MH-Electronic/RISC-V-Processor-Design/Documents/EEE499_FYPSLIDES-LIEW_MING_HENG.pdf

## Efficient VLSI Design-Based Adaptive Pipelined RISC-V Core

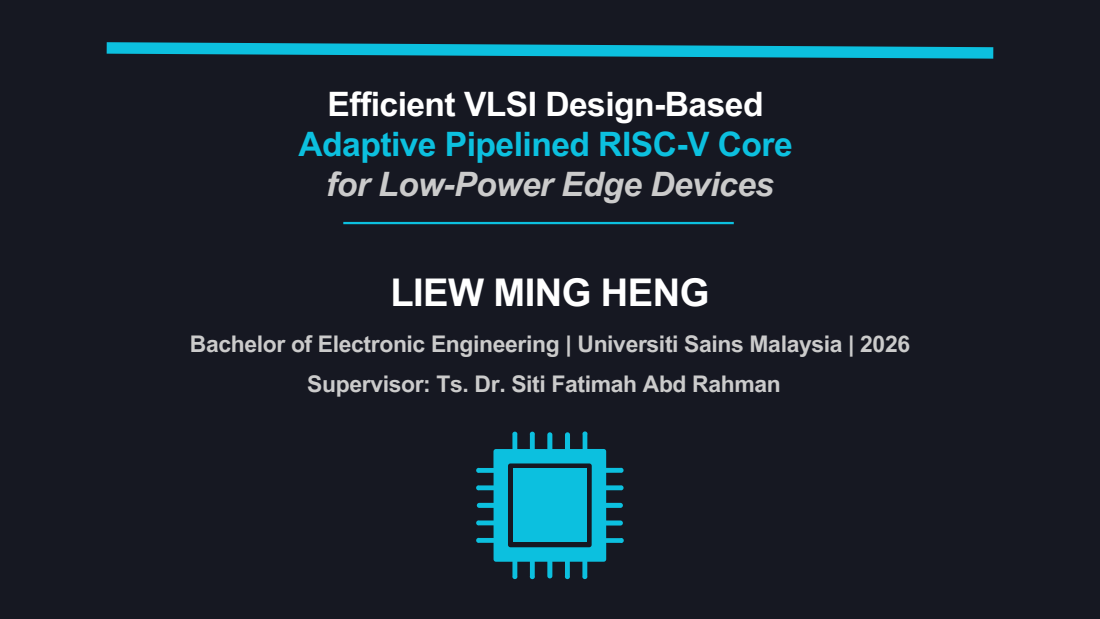
[picture p48: page 1]

for Low-Power Edge Devices

LIEW MING HENG

Bachelor of Electronic Engineering | Universiti Sains Malaysia | 2026

Supervisor: Ts. Dr. Siti Fatimah Abd Rahman

## RESEARCH BACKGROUND

## PROBLEM STATEMENT

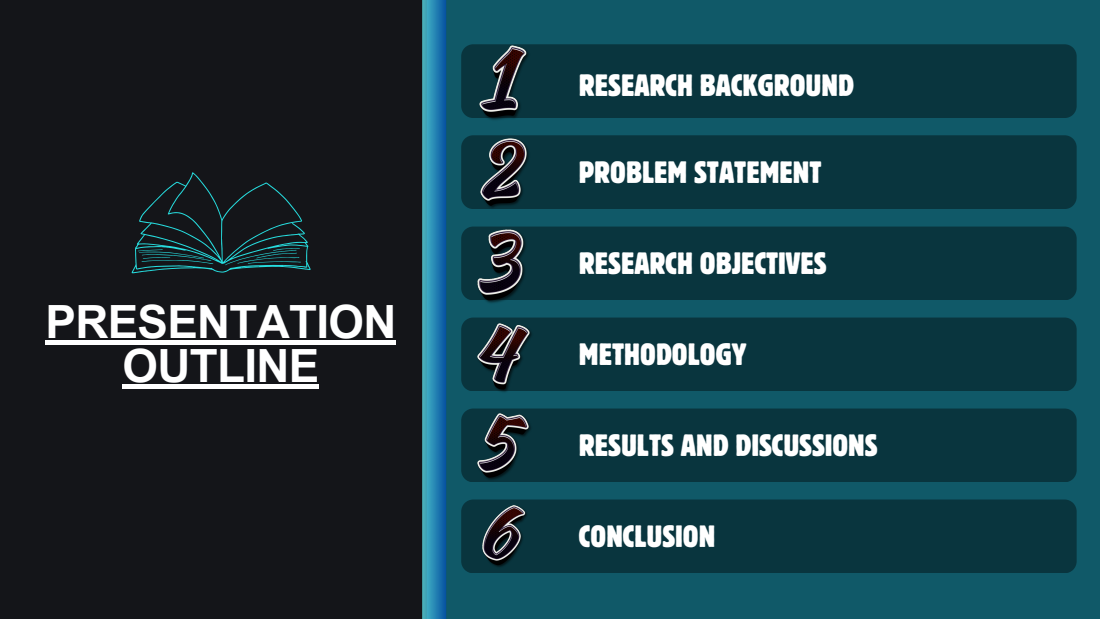
[picture p49: page 2]
PRESENTATION OUTLINE; RESEARCH OBJECTIVES; METHODOLOGY; CONCLUSION

RESULTS AND DISCUSSIONS

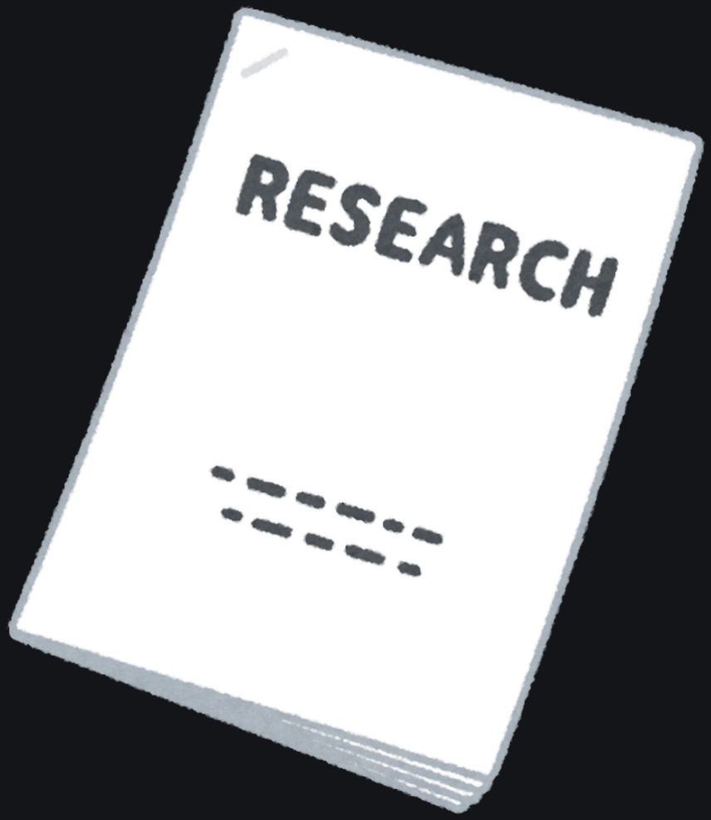
[picture p50: figure]

# RESEARCH BACKGROUND

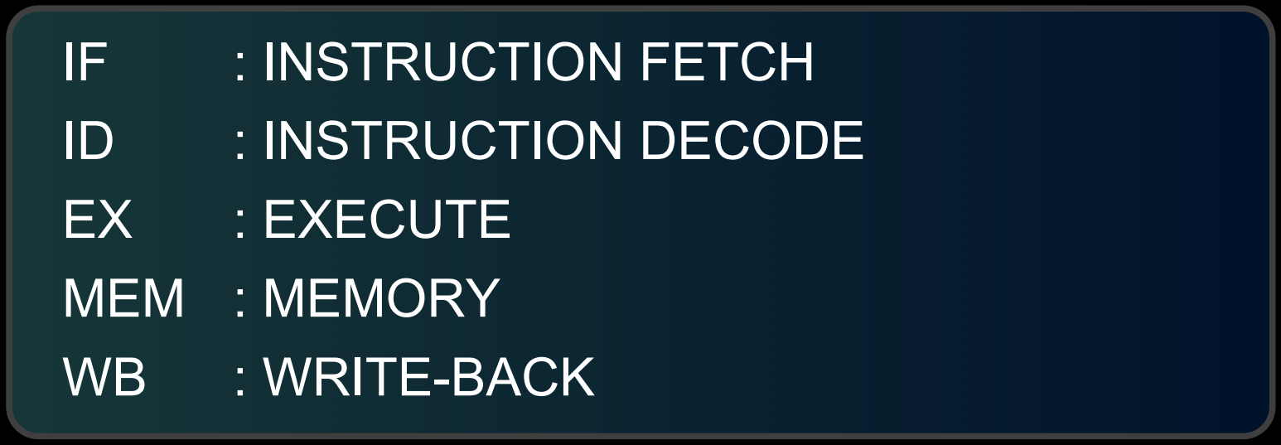
[picture p51: figure]
IF ID EX MEM WB; : INSTRUCTION FETCH : INSTRUCTION DECODE : EXECUTE : MEMORY : WRITE-BACK
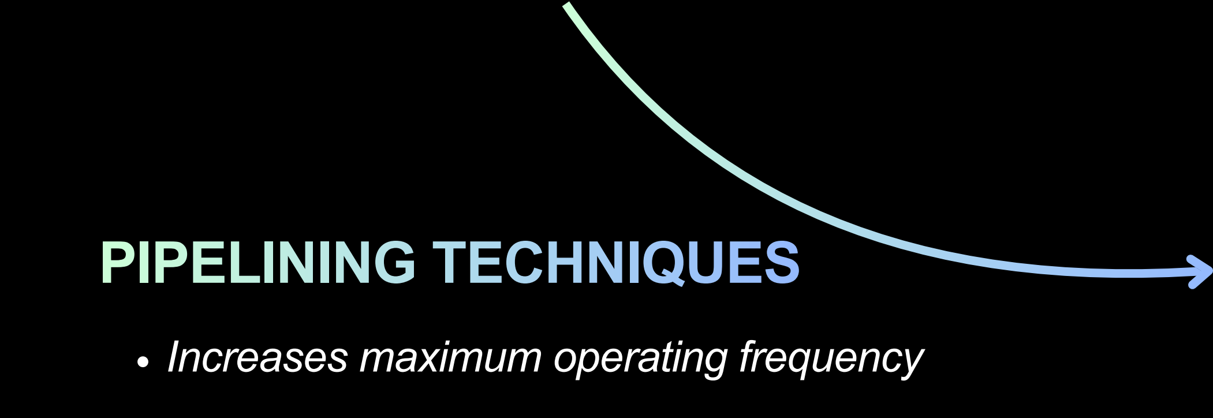
[picture p52: figure]
PIPELINING TECHNIQUES; Increases maximum operating frequency

## 5-STAGE PROCESSOR

# RESEARCH BACKGROUND

## SINGLE-CYCLE PROCESSOR

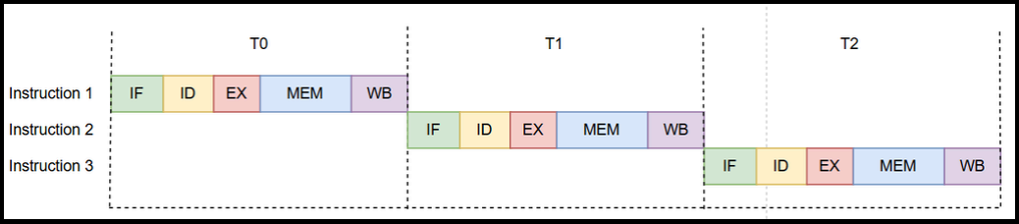
[picture p53: figure]
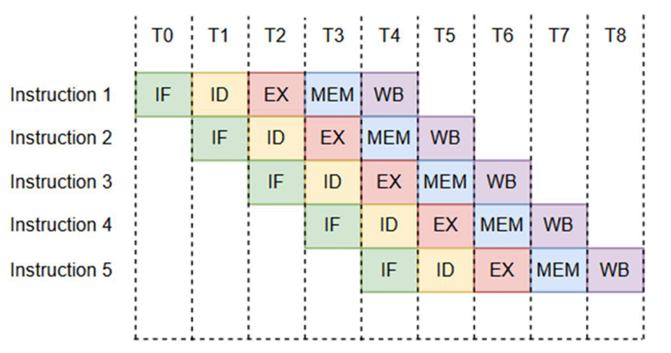
[picture p54: figure]

## DYNAMIC POWER EQUATION

α: Switching Activity Factor C: Effective Load Capacitance V: Supply Voltage
f: Operating Frequency

# RESEARCH BACKGROUND

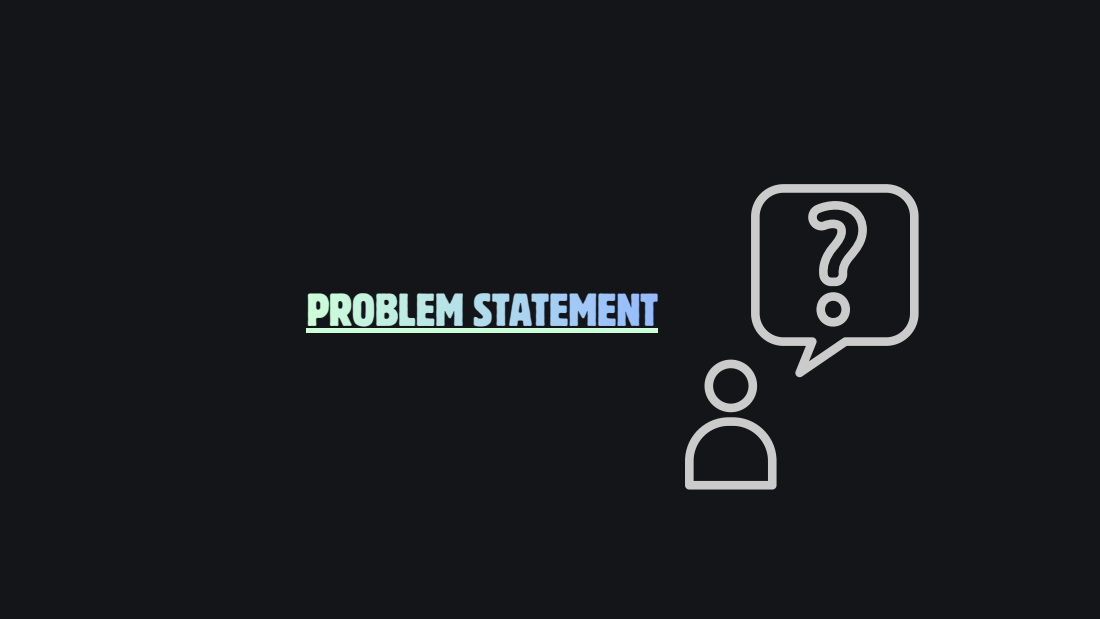
[picture p55: page 6]
PROBLEM STATEMENT

## PROBLEM STATEMENT

PROBLEM 1: RIGID PIPELINE TRADE-OFF & HAZARD PENALTY

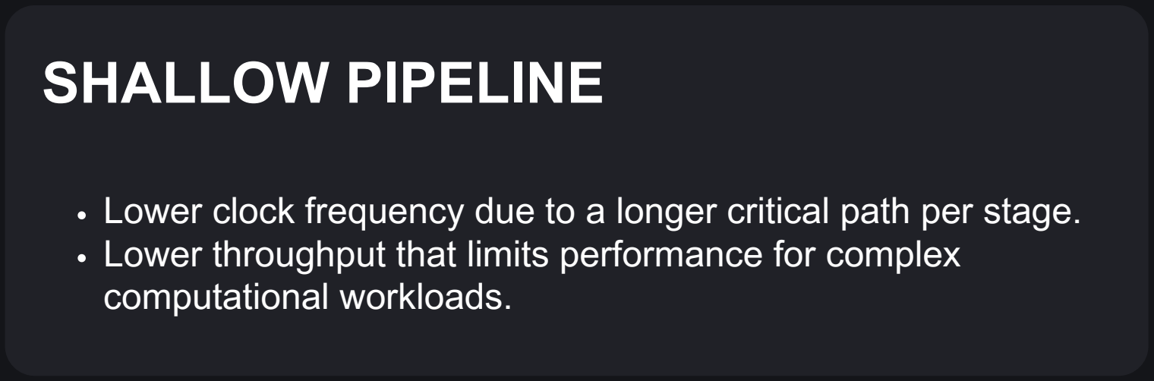
[picture p56: figure]
computational workloads.; SHALLOW PIPELINE
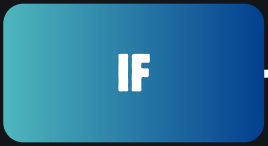
[picture p57: figure]
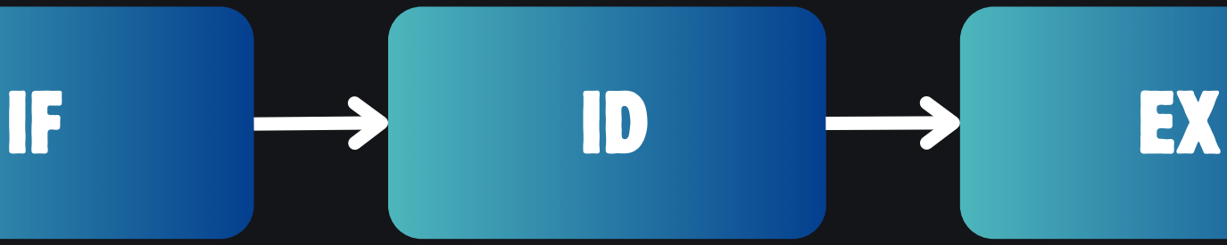
[picture p58: figure]
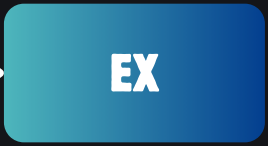
[picture p59: figure]

Lower clock frequency due to a longer critical path per stage. Lower throughput that limits performance for complex

IF | ID | EX | MEM | WB

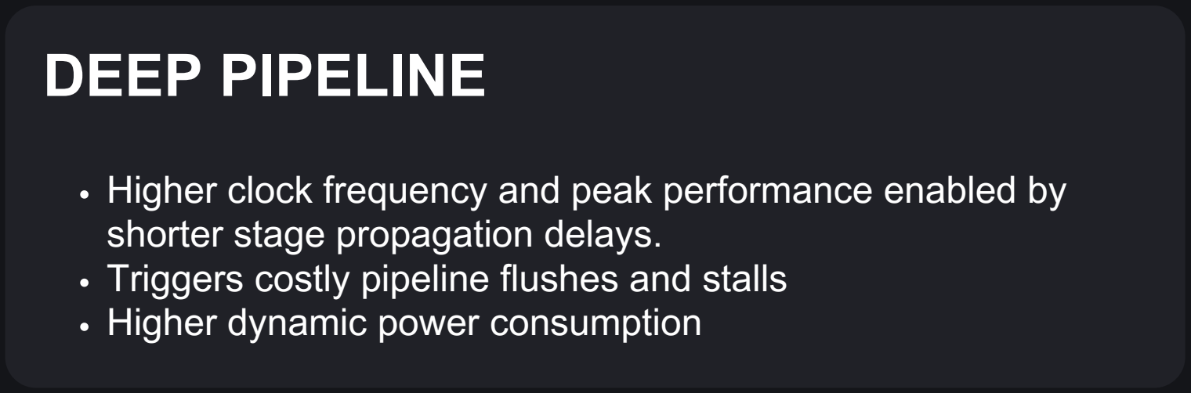
[picture p60: figure]
DEEP PIPELINE; shorter stage propagation delays.; Higher dynamic power consumption

Higher clock frequency and peak performance enabled by

Triggers costly pipeline flushes and stalls

## PROBLEM STATEMENT

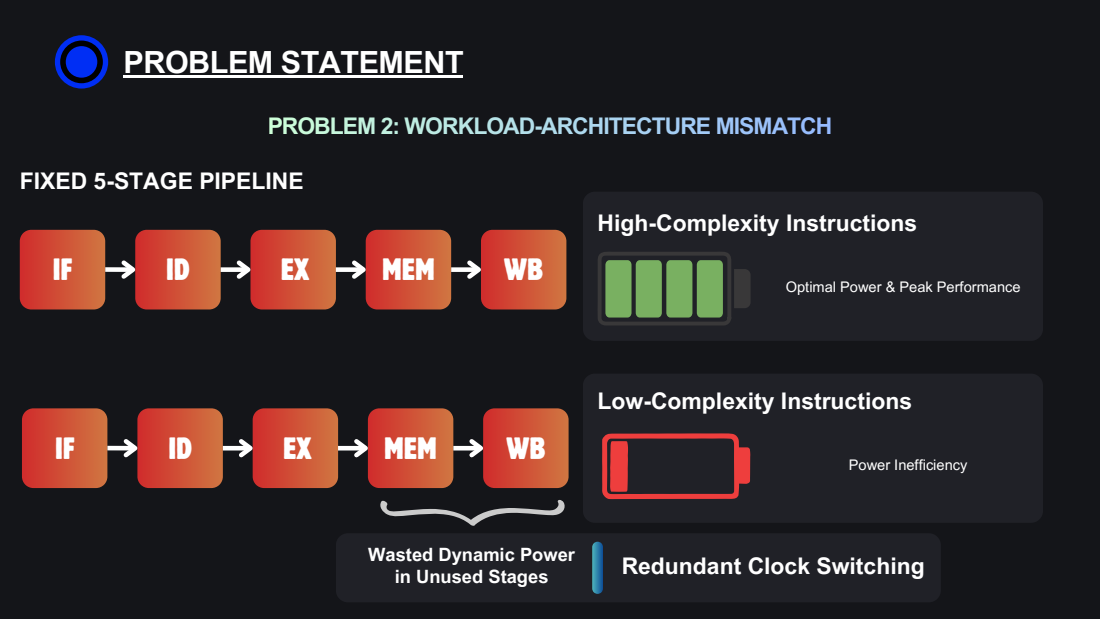
[picture p61: page 8]
MEM; Power Inefficiency; in Unused Stages; Redundant Clock Switching

PROBLEM 2: WORKLOAD-ARCHITECTURE MISMATCH

FIXED 5-STAGE PIPELINE

High-Complexity Instructions

Optimal Power & Peak Performance

Low-Complexity Instructions

Wasted Dynamic Power

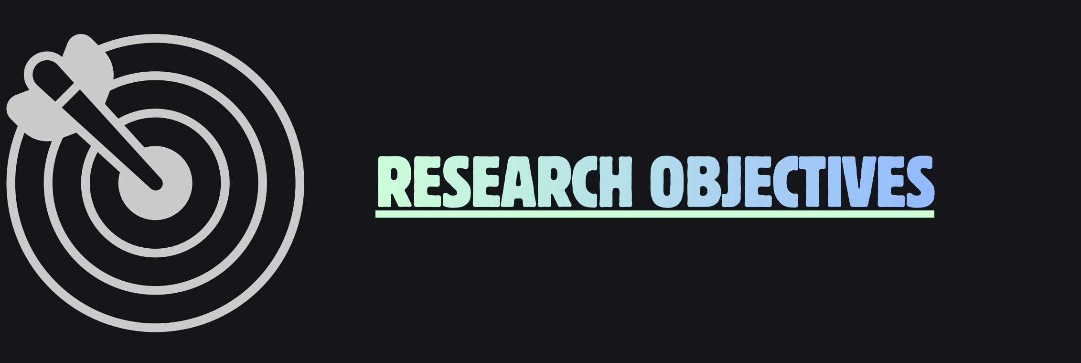
[picture p62: figure]
RESEARCH OBJECTIVES

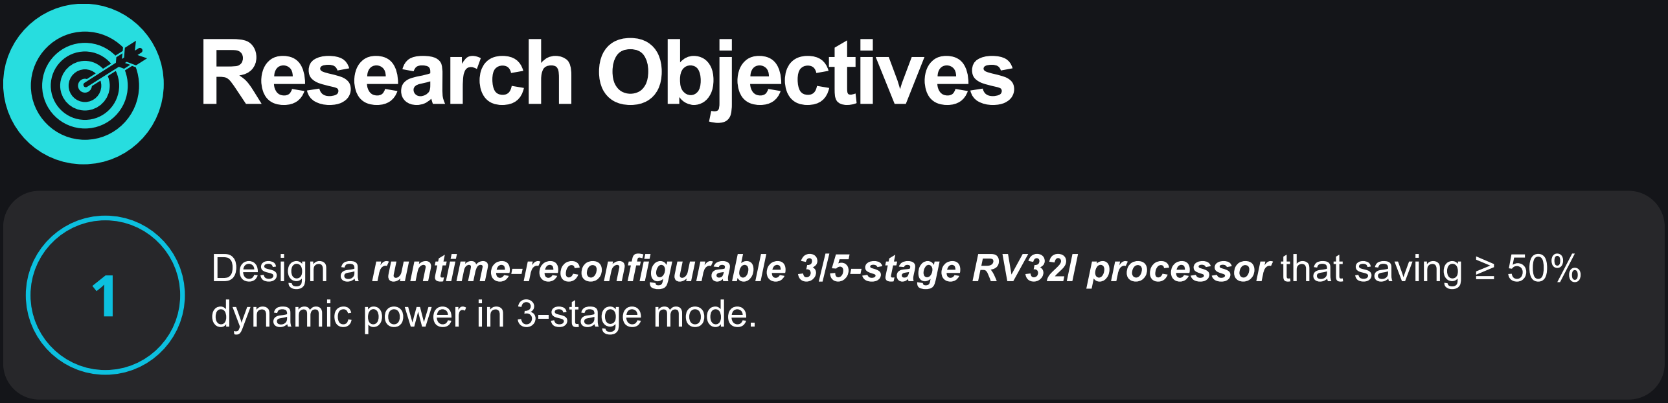
[picture p63: figure]
Research Objectives; dynamic power in 3-stage mode.

Design a runtime-reconfigurable 3/5-stage RV32I processor that saving ≥ 50%

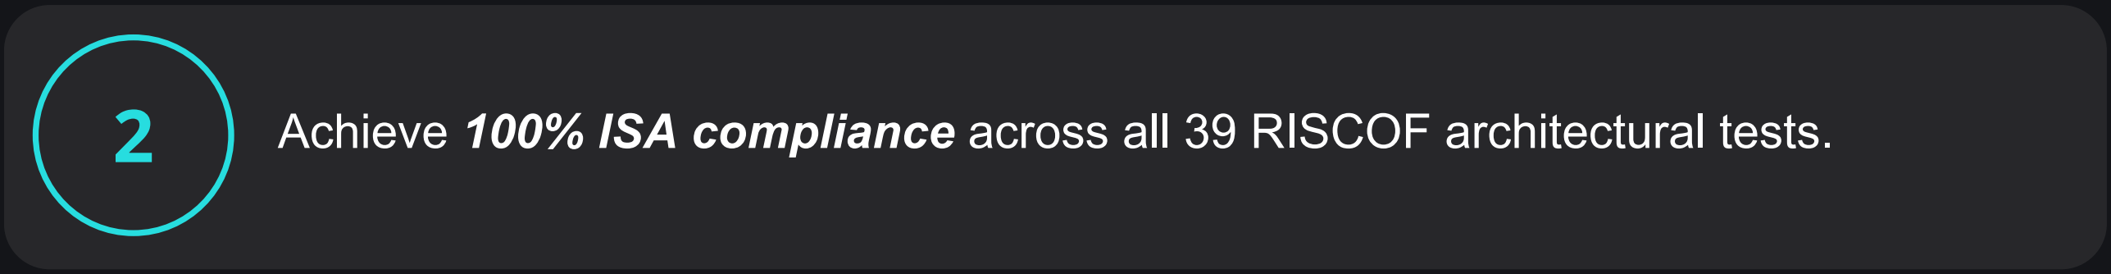
[picture p64: figure]

Achieve 100% ISA compliance across all 39 RISCOF architectural tests.

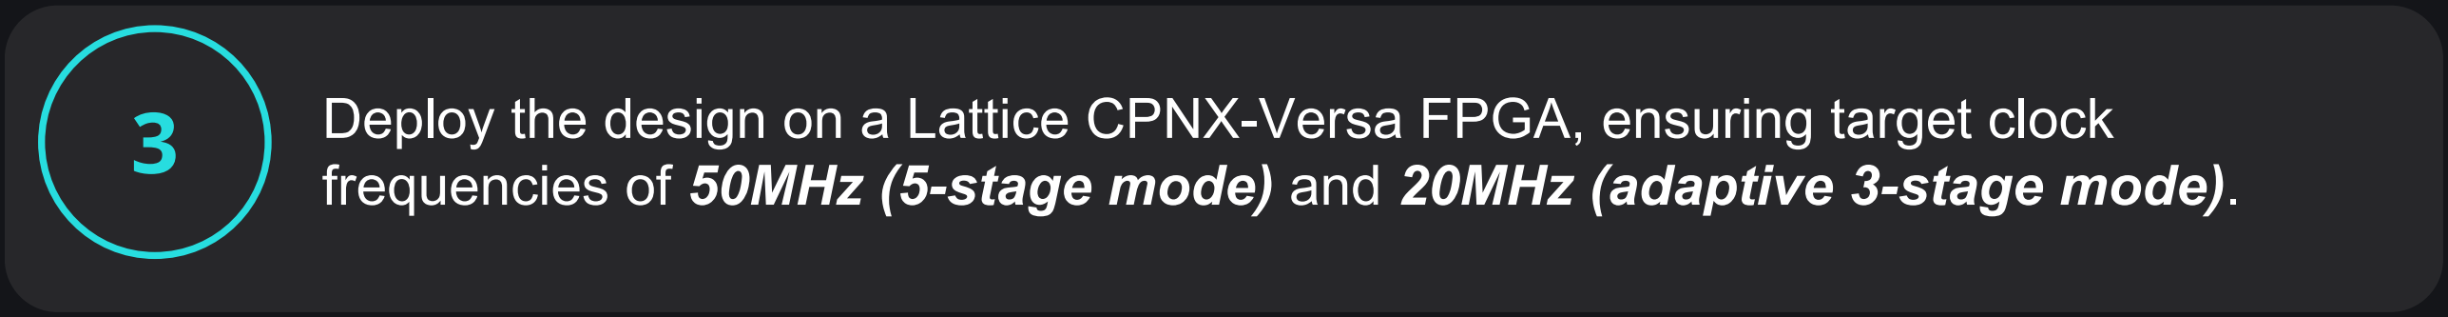
[picture p65: figure]

Deploy the design on a Lattice CPNX-Versa FPGA, ensuring target clock frequencies of 50MHz (5-stage mode) and 20MHz (adaptive 3-stage mode).

# Existed Research vs Proposed Work

Minimalist Soft-Cores | High-Performance | Proposed Work
PicoRV32 | Rocket SSR

Pipeline Depth

Hazard Strategy
Overhead

Verification

Application

Rigid Multi-Cycle | Rigid Fixed 5-Stage | Runtime- Reconfigurable
Zero | High Power Penalty | Dynamic Elimination via Stage Unification
Local Testbenches | RISCOF | RISCOF
FPGA Soft-Core | ASIC | Lattice CPNX FPGA

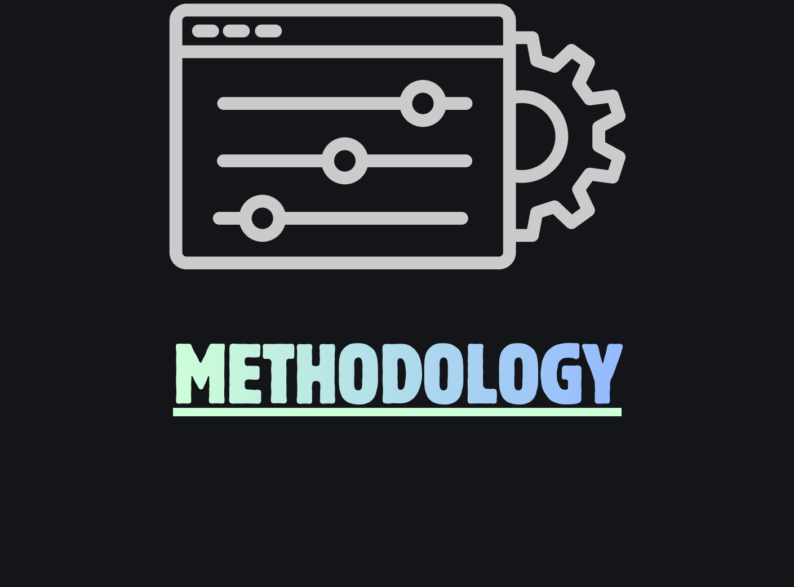
[picture p66: figure]
METHODOLOGY
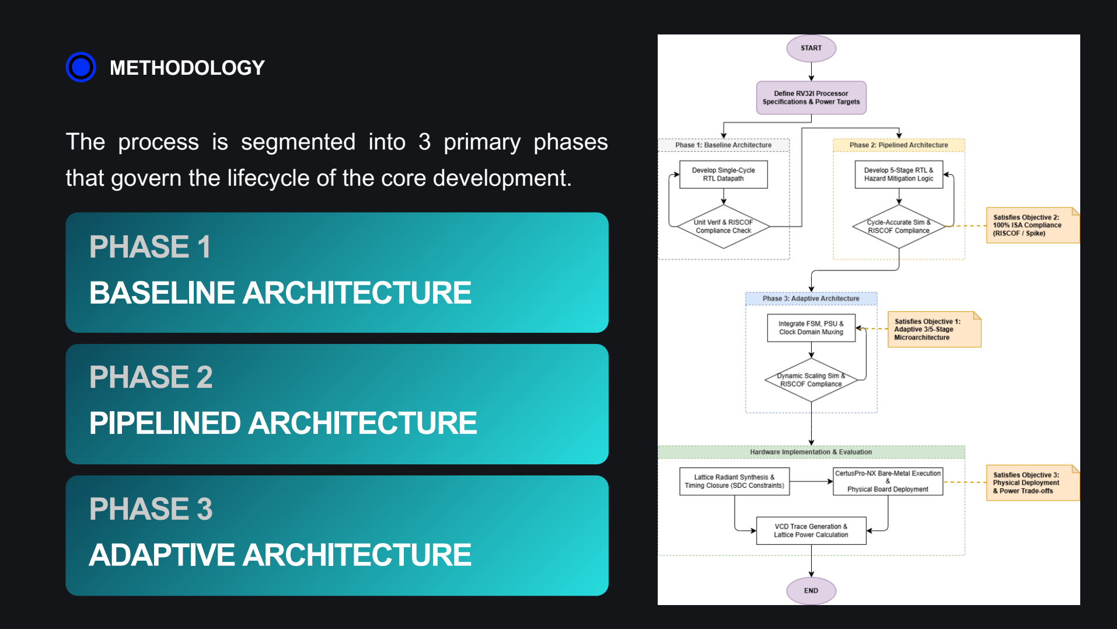
[picture p67: page 13]

The process is segmented into 3 primary phases that govern the lifecycle of the core development.

METHODOLOGY

## PHASE 3 ADAPTIVE ARCHITECTURE

## PHASE 2 PIPELINED ARCHITECTURE

## PHASE 1 BASELINE ARCHITECTURE

# Project Resources

SOFTWARE | HARDWARE

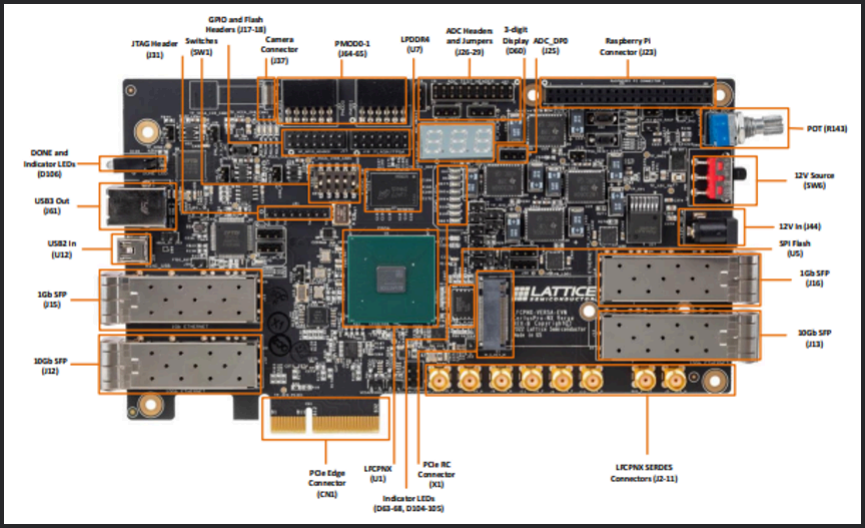
[picture p68: figure]

Lattice CPNX Versa FPGA Board

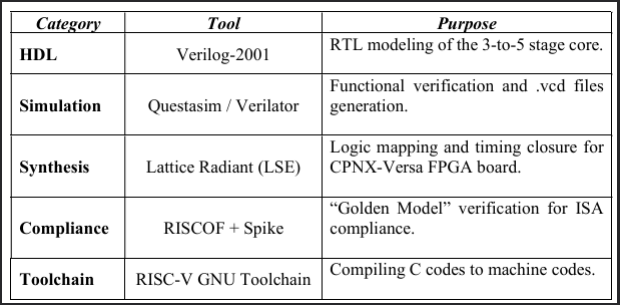
[picture p69: figure]

## PHASE 1

## Own Design

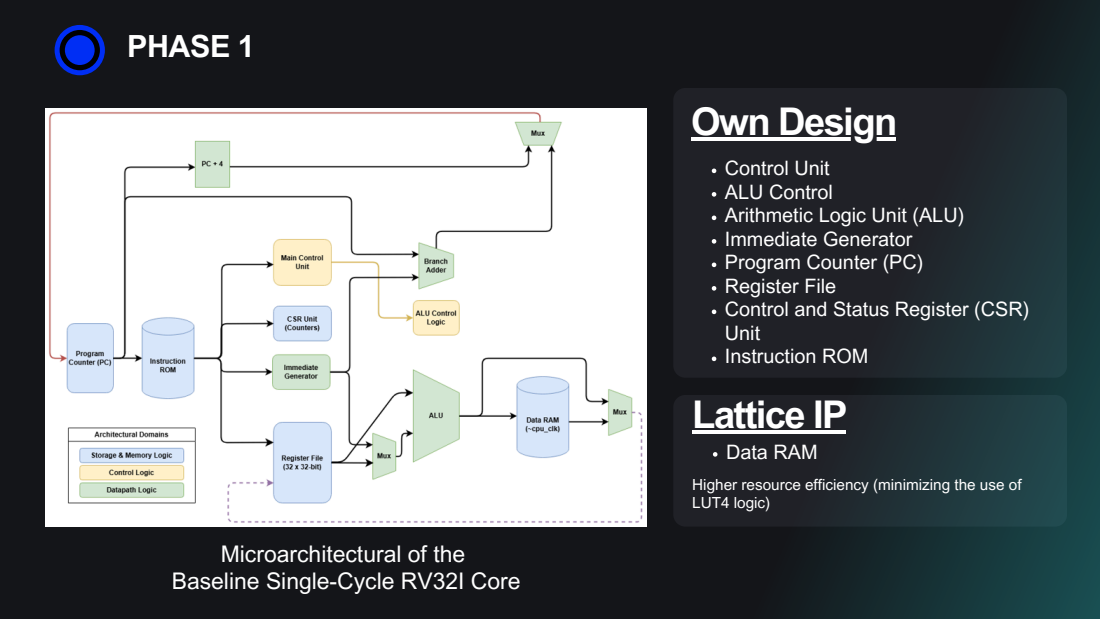
[picture p70: page 15]
Data RAM

Control Unit
ALU Control
Arithmetic Logic Unit (ALU)
Immediate Generator
Program Counter (PC)
Register File
Control and Status Register (CSR)
Unit
Instruction ROM
Lattice IP

Higher resource efficiency (minimizing the use of
LUT4 logic)

Microarchitectural of the
Baseline Single-Cycle RV32I Core

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
## PHASE 2

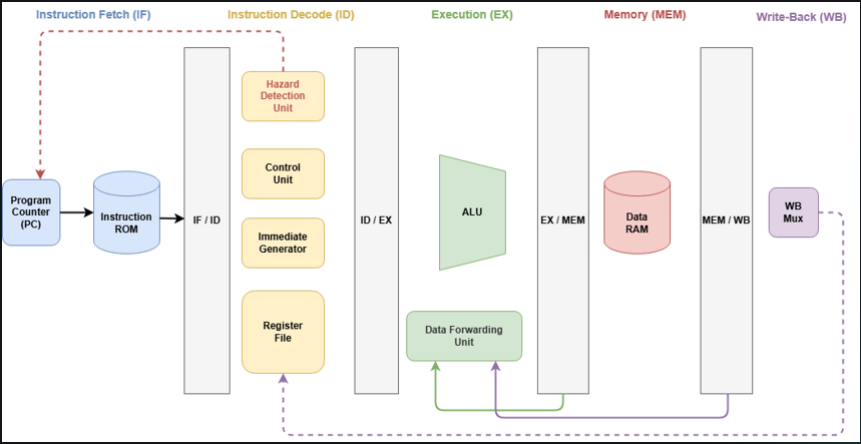
[picture p71: figure]

Microarchitectural of the
5-Stage Pipelined RV32I Core

## PHASE 2

# Hazard Mitigation Logics

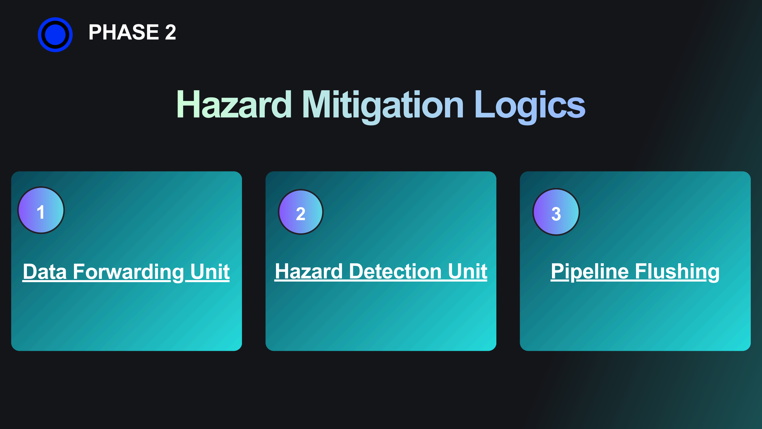
[picture p72: page 18]

1
2 3
Data Forwarding Unit | Hazard Detection Unit | Pipeline Flushing

## PHASE 2

# Hazard Mitigation Logics

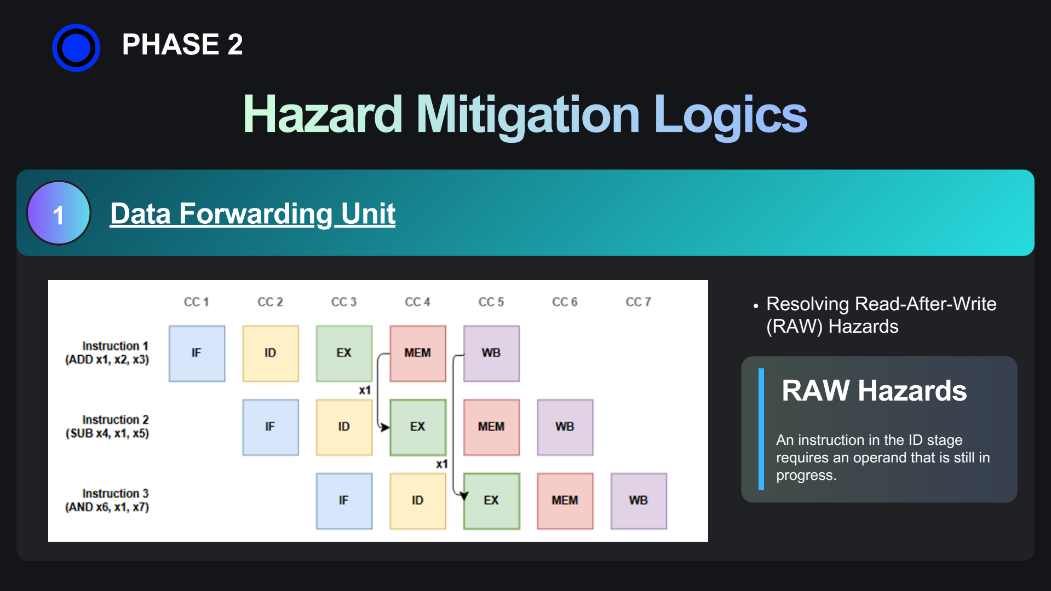
[picture p73: page 19]

1

## Data Forwarding Unit

Resolving Read-After-Write (RAW) Hazards

## RAW Hazards

An instruction in the ID stage requires an operand that is still in progress.

## PHASE 2

# Hazard Mitigation Logics

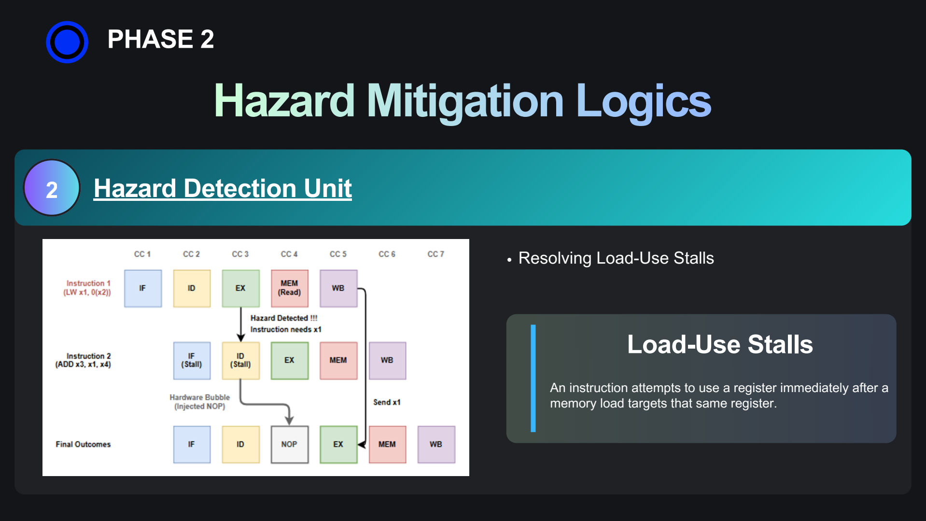
[picture p74: page 20]

2

## Hazard Detection Unit

Resolving Load-Use Stalls

## Load-Use Stalls

An instruction attempts to use a register immediately after a memory load targets that same register.

## PHASE 2

# Hazard Mitigation Logics

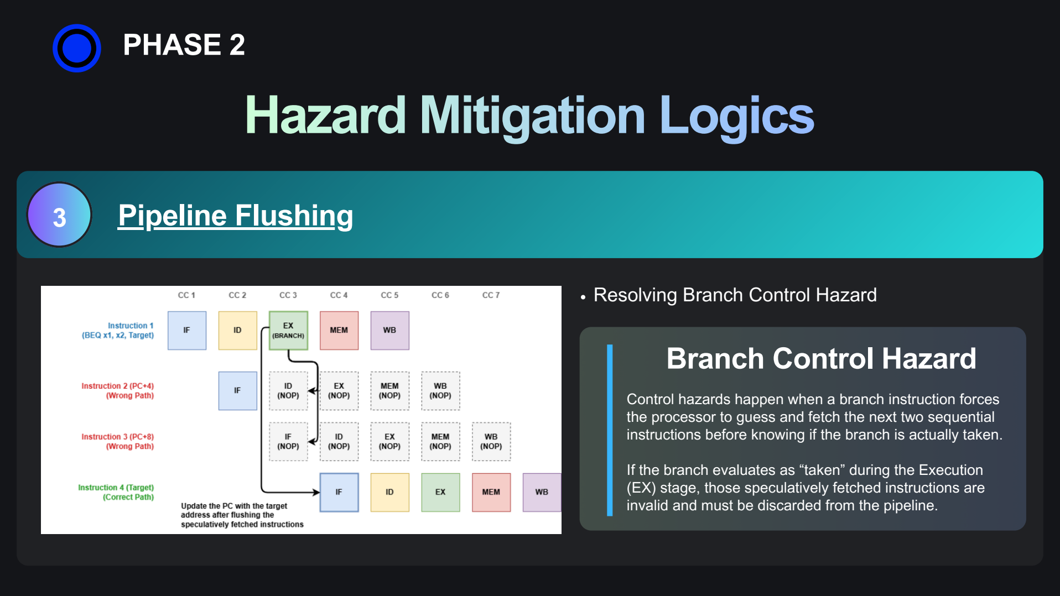
[picture p75: page 21]

3

## Pipeline Flushing

Resolving Branch Control Hazard

## Branch Control Hazard

Control hazards happen when a branch instruction forces the processor to guess and fetch the next two sequential instructions before knowing if the branch is actually taken.

If the branch evaluates as “taken” during the Execution (EX) stage, those speculatively fetched instructions are invalid and must be discarded from the pipeline.

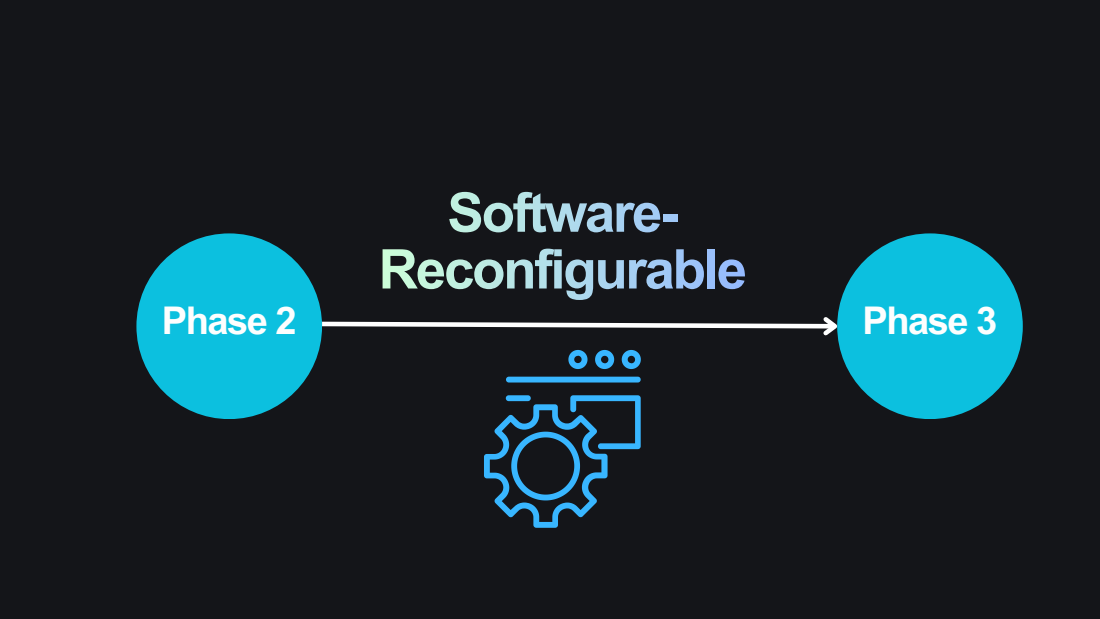
[picture p76: page 22]
ftwa re

## PHASE 3

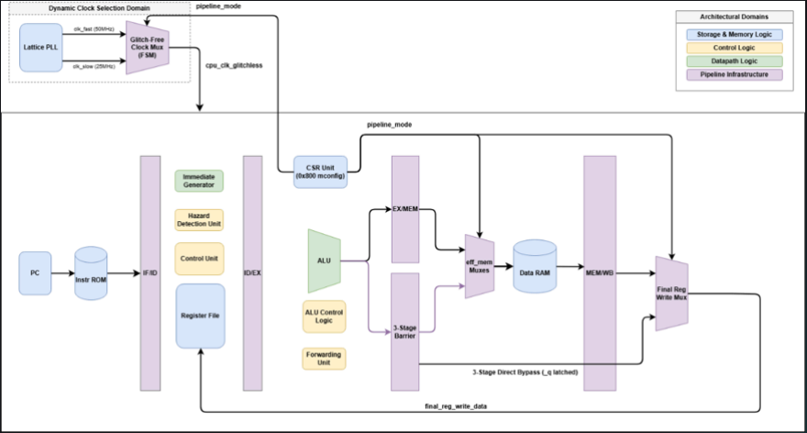
[picture p77: figure]

Microarchitectural of the
Adaptive RV32I Core

## Dual-Clock Domain Architecture

## Operand Isolation (Combinational Power Gating)

PHASE 3

A dual-domain clocking strategy is required because the 5-stage mode demands 50 MHz for high performance, while the 3-stage mode must run at 20 MHz to avoid timing violations and maximize power savings by 60%.

While dual-clocking reduces frequency-based power, freezing operand propagation through the ALU during pipeline stalls or NOP bubbles eliminates useless gate toggling, lowering the switching activity factor to save dynamic energy.

## PHASE 3

# Glitch-Free Dual-Clock Domain Technique

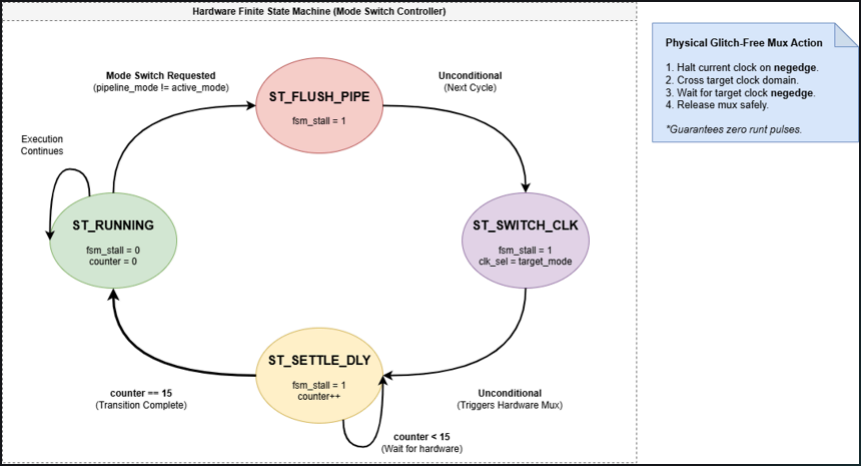
[picture p78: figure]

## PHASE 3

# Combinational Power Gating (Operand Isolation)

# Combinational Power Gating (Operand Isolation)

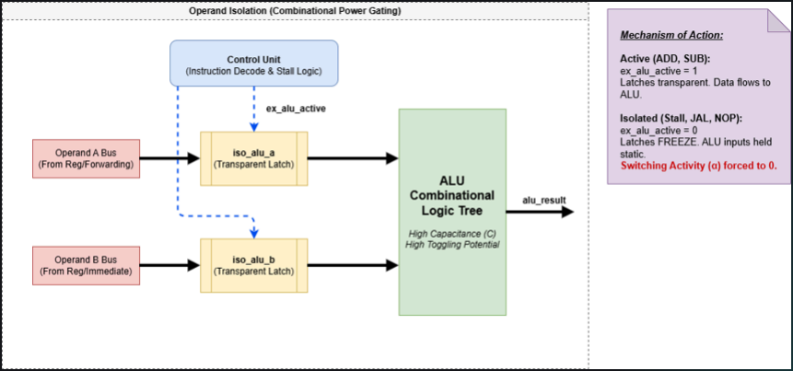
[picture p79: figure]

## HOW IT WORKS WHEN IN 3-STAGE MODE

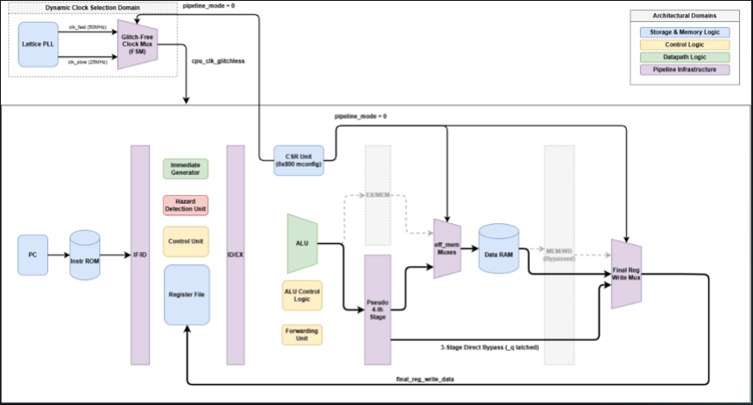
[picture p80: figure]

3-STAGE MODE

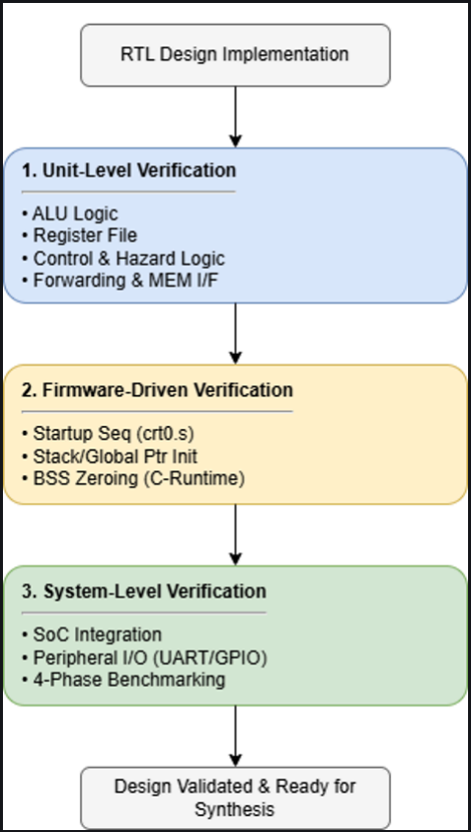
[picture p81: figure]
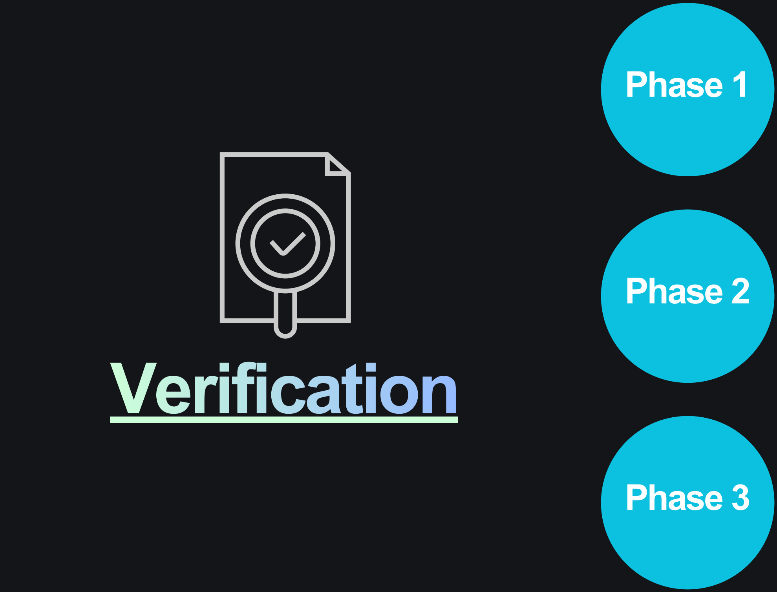
[picture p82: figure]
Phase 2; Phase 3; Phase 1; Verification

# Problem Faced

# Problem Faced

## Functional Corretness & Hidden Bugs

## Clock Glitches & Metastability

Dynamically switching between two asynchronous clock domains (50 MHz and 20 MHz) using simple logic gates creates clock glitches and flip-flop metastability.

Manual testing cannot easily uncover hidden architectural bugs, corner cases, or hidden data hazards introduced by the flexible, runtime-reconfigurable pipeline logic.

Conducted unit-level verification via isolated testbenches to validate the functional correctness of individual hardware modules (ALU, FSM, Hazard Unit).

Developed a dedicated Mode Switch Controller driven by a 4-state Finite State Machine to safely intercept `pipeline_mode` requests and smoothly orchestrate the clock domain crossings without hardware glitches.

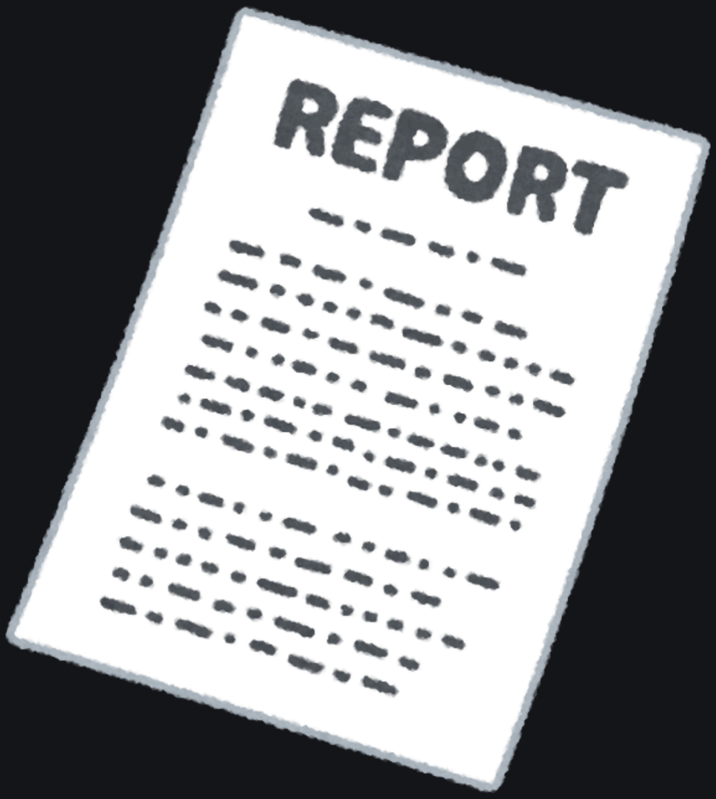
[picture p83: figure]

# RESULTS AND DISCUSSIONS

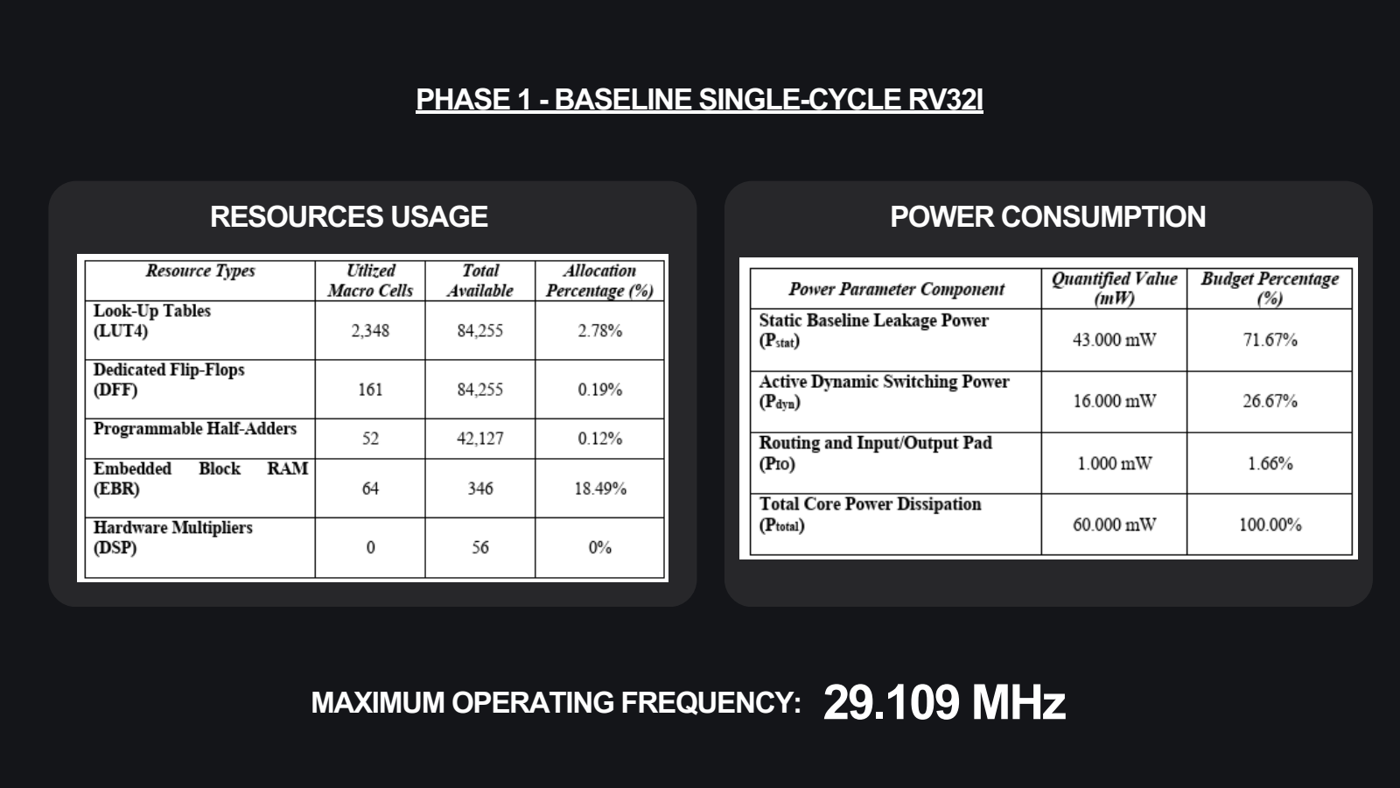
[picture p84: page 31]

RESOURCES USAGE

PHASE 1 - BASELINE SINGLE-CYCLE RV32I

MAXIMUM OPERATING FREQUENCY: 29.109 MHz

POWER CONSUMPTION

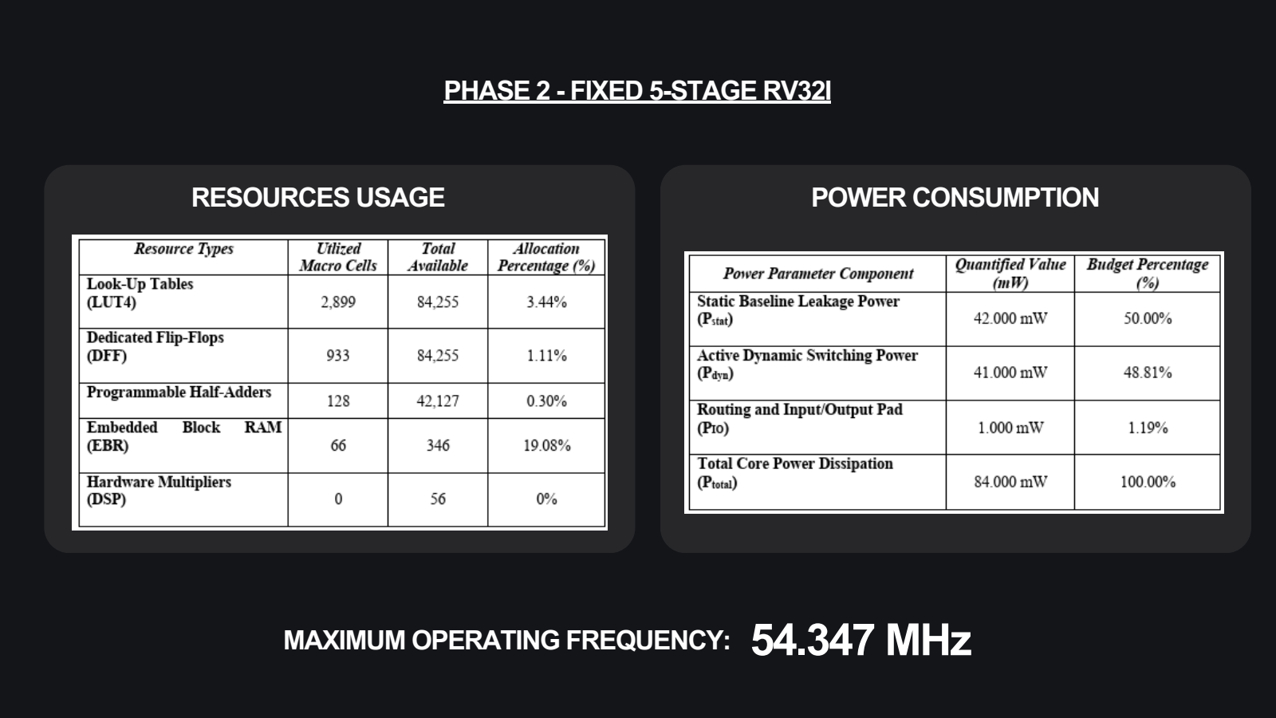
[picture p85: page 32]

RESOURCES USAGE

PHASE 2 - FIXED 5-STAGE RV32I

MAXIMUM OPERATING FREQUENCY: 54.347 MHz

POWER CONSUMPTION

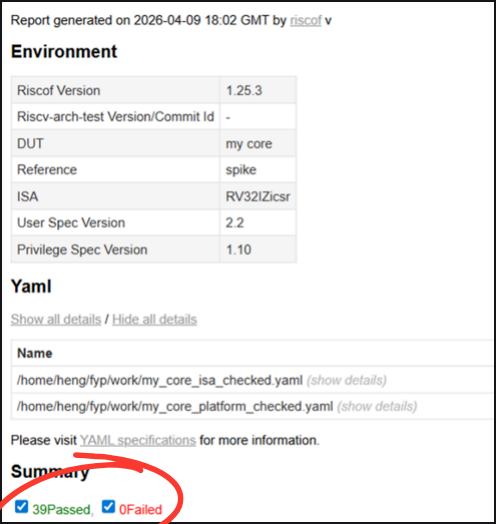
[picture p86: figure]

To validate the pipelined 5-stage core was functionally correct before proceeding to adaptive core, formal verification was conducted using the RISCOF framework within WSL2. The 5-stage core achieved 100% compliance, passing all 39 standard RV32I architectural test suites by matching its memory signatures byte-for-byte against the Spike reference model.

WSL2: Windows Subsystem for Linux

PHASE 2 - FIXED 5-STAGE RV32I

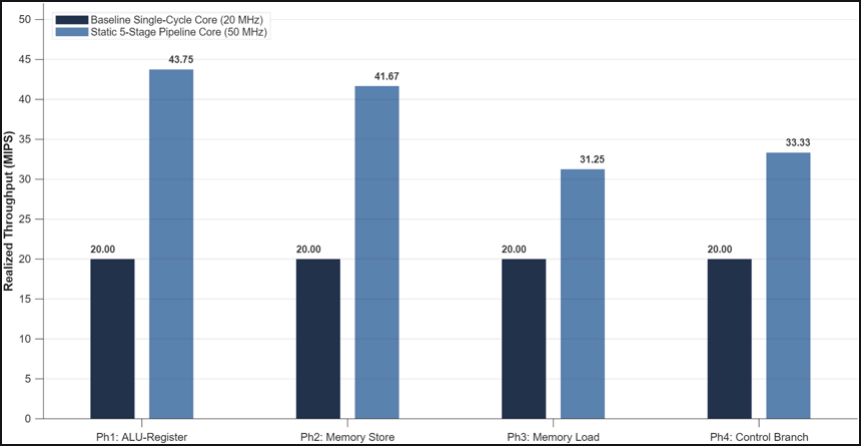
[picture p87: figure]

Realized MIPS Throughput Comparison Bewteen Single-Cycle RV32I and Static 5-Stage RV32I

PHASE 2 - FIXED 5-STAGE RV32I

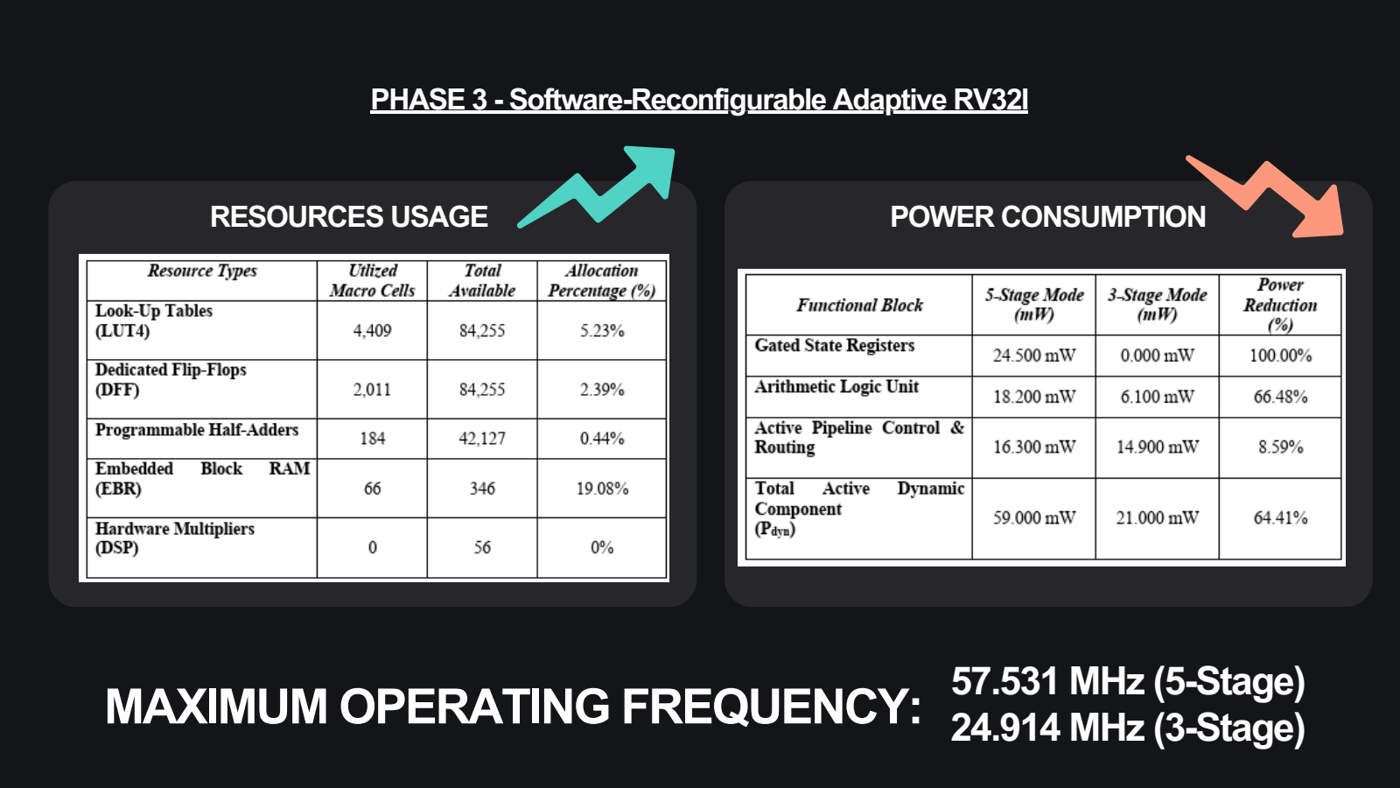
[picture p88: page 35]

RESOURCES USAGE

PHASE 3 - Software-Reconfigurable Adaptive RV32I

POWER CONSUMPTION

## MAXIMUM OPERATING FREQUENCY:

## 57.531 MHz (5-Stage) 24.914 MHz (3-Stage)

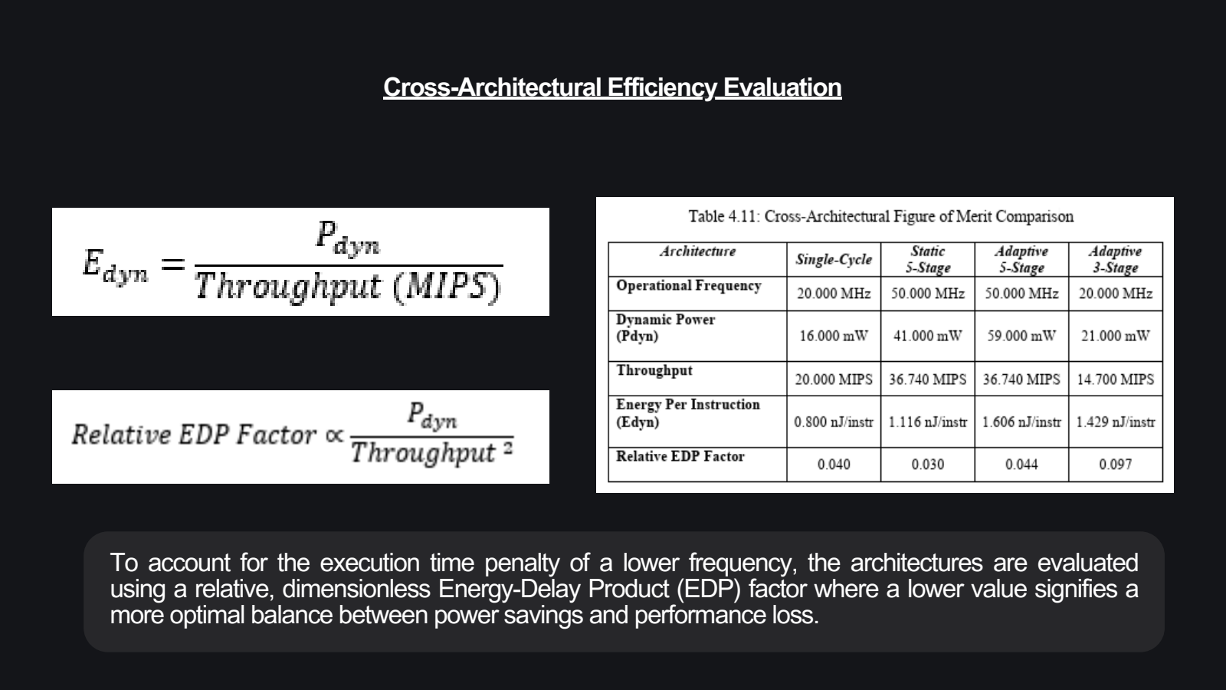
[picture p89: page 36]

Cross-Architectural Efficiency Evaluation

To account for the execution time penalty of a lower frequency, the architectures are evaluated using a relative, dimensionless Energy-Delay Product (EDP) factor where a lower value signifies a more optimal balance between power savings and performance loss.

Architectural Efficiency Comparison across Four Hardware Configurations

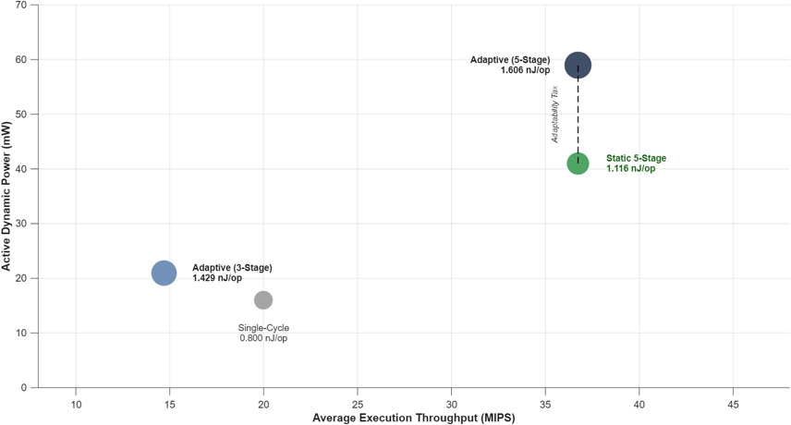
[picture p90: figure]

Average Dynamic Power vs Average Execution Throughput

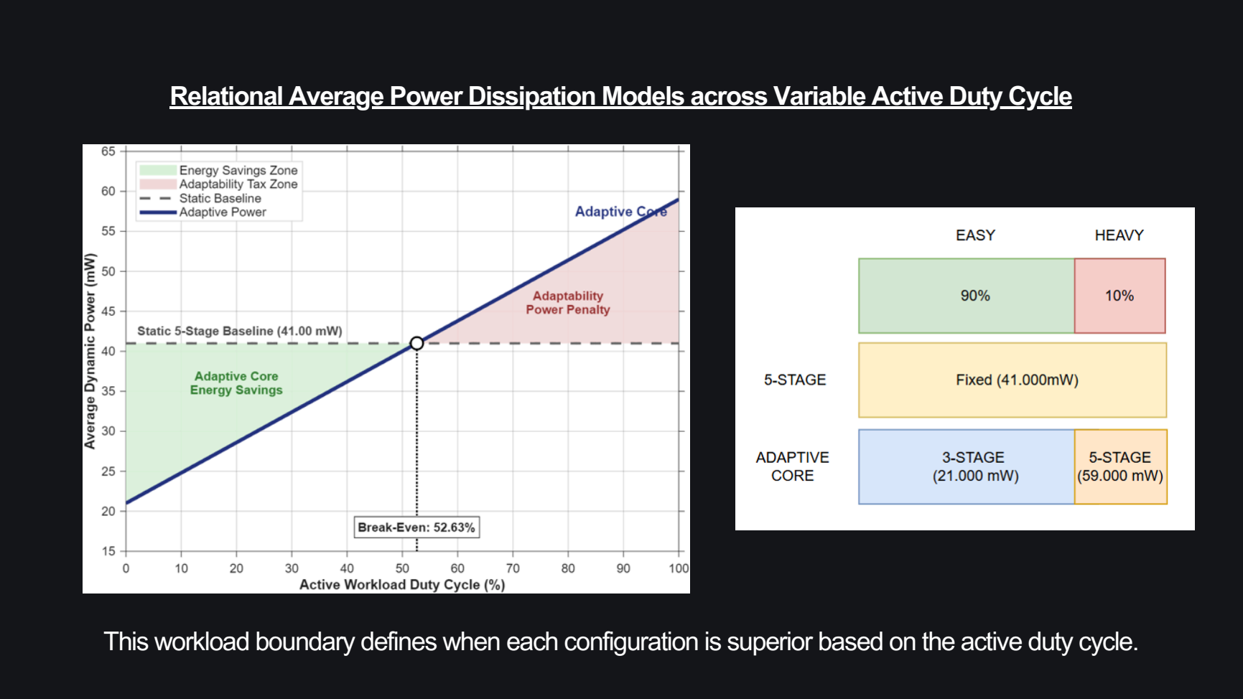
[picture p91: page 38]

Relational Average Power Dissipation Models across Variable Active Duty Cycle

This workload boundary defines when each configuration is superior based on the active duty cycle.

# Hardware Implementation

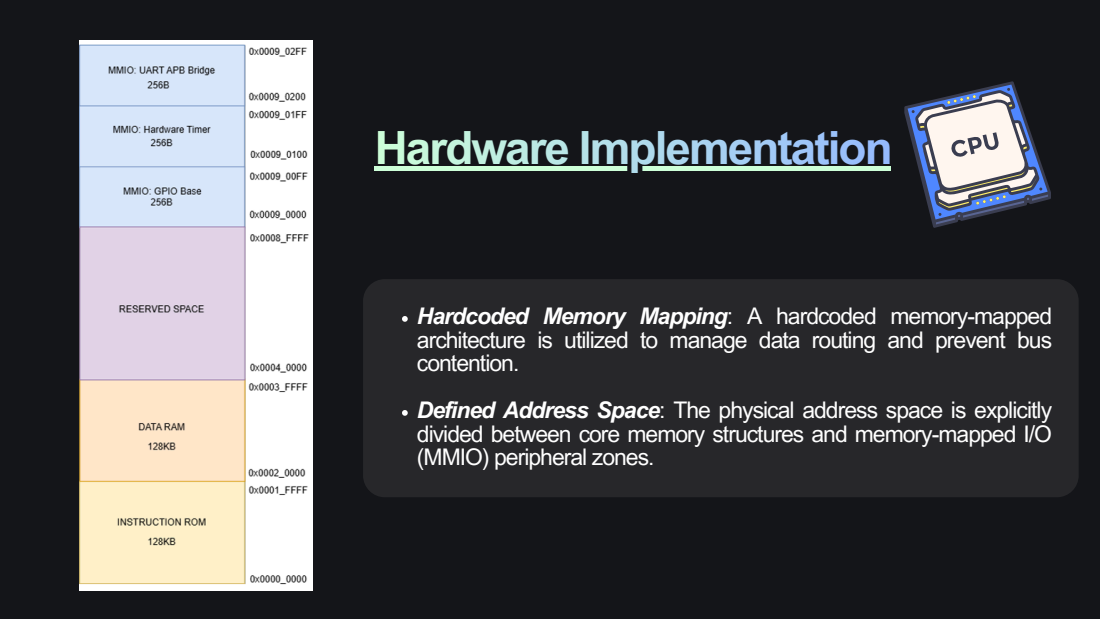
[picture p92: page 39]

Hardcoded Memory Mapping: A hardcoded memory-mapped
architecture is utilized to manage data routing and prevent bus
contention.

Defined Address Space: The physical address space is explicitly
divided between core memory structures and memory-mapped I/O
(MMIO) peripheral zones.

DEMO

# DEMO

# Future Works

Integration of Standard Hardware Extensions: Expand the instruction set architecture beyond the base RV32I profile by integrating the standard RISC-V 'M' extension. This implements dedicated hardware multiplication and division units, eliminating the latency and execution overhead of software emulation libraries for compute-heavy tasks.

Automated Hardware Performance Monitoring: Transition from manual, software-driven mode switches via explicit CSR writes to a fully automated hardware mechanism. Integrating an on-chip monitor to track real-time pipeline stall rates and instruction retirement metrics would allow the core to self-scale its execution depth dynamically.

ASIC Migration and Fine-Grained DVFS: Migrate the RTL design from programmable FPGA fabric to a standard-cell ASIC flow to eliminate high static logic leakage. Moving to custom silicon enables true Dynamic Voltage and Frequency Scaling (DVFS), allowing the core voltage to scale down alongside the 20 MHz clock to maximize energy savings for ultra-low-power commercial IoT applications.

# PROJECT SCHEDULE

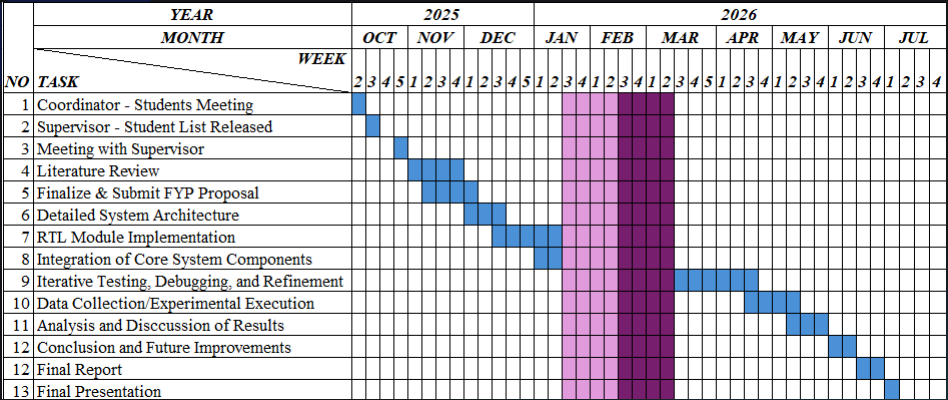
[picture p93: figure]

# CONCLUSION

Adaptive RV32I Architecture: Successfully implemented a software-reconfigurable processor that dynamically transitions between a 5-stage performance mode and a 3-stage low-power mode to balance throughput and energy demands.

Dual-Domain Clocking & Mitigation: Resolved the propagation delay of the collapsed 3-stage mode by using a custom 4-state FSM controller to safely drop the clock from 50 MHz to 20 MHz without glitches, backed by a hazard mitigation logic that achieved 100% RISCOF compliance.

Switching Activity Optimization: Maximized dynamic energy savings by freezing operand propagation through the ALU during pipeline stalls and NOP bubbles, effectively eliminating useless gate toggling.

Proven Efficiency Boundaries: Quantified a clear workload boundary at a 52.63% duty cycle. At a realistic 10% edge-computing duty cycle, the adaptive core cuts average power to 24.800 mW, yielding a 39.51% energy savings over the static baseline.

Question & Feedback
Q & A

END

# THANK YOU
