MH-Electronic/RISC-V-Processor-Design/Phase2_5_Stage/rtl/system_top.v

// =============================================================================
// system_top.v  —  SoC Integration (5-Stage Pipelined Core)
// EEE499 FYP | Liew Ming Heng (161439) | USM
// =============================================================================
//
// CHANGES vs ORIGINAL system_top.v
// ----------------------------------
//   CHANGE 1: data_ram clock — CRITICAL TIMING FIX
//     BEFORE: .clk_i (~cpu_clk)   ← external clock inversion
//     AFTER:  .clk_i (cpu_clk)    ← direct clock; data_ram.v handles edges
//
//     Why this improves Fmax:
//       The original design passed (~cpu_clk) to the Lattice EBR IP.
//       This inserted a clock inverter cell into the clock path, adding
//       ~0.3–0.8 ns of routing delay to every posedge→negedge timing path.
//       The STA report shows 79.2% routing delay on the critical path
//       (EX/MEM register → RAM Write Enable), which includes this inverter.
//       The custom data_ram.v uses internal always @(posedge) and
//       always @(negedge) blocks so the synthesis tool maps directly to
//       EBR dual-edge primitives without an external inverter.
//       Estimated Fmax improvement: 54.3 MHz → ~60–68 MHz.
//
//   CHANGE 2: test_finished double-driver removed
//     The original had "assign test_finished = core_finish || is_tohost_write"
//     appearing TWICE in the module — once in an intermediate comment block
//     and once in the main flow. This is a multiple-driver error that
//     produces X in simulation. Only one assignment is kept.
//
//   CHANGE 3: Address decode corrected for 5-stage memory map
//     RAM:  alu_result_out[31:16] == 16'h8001  (0x80010000–0x8001FFFF)
//     ROM:  alu_result_out[31:16] == 16'h8000  (0x80000000–0x8000FFFF)
//     GPIO: alu_result_out[31:8]  == 24'h900000 (0x90000000–0x900000FF)
//
//     The original used [31:22] comparisons that incorrectly matched a much
//     wider address range and failed to distinguish ROM from RAM (both have
//     bit 31 set in your memory map). The corrected [31:16] decode correctly
//     isolates each 64 KB region.
//
//   CHANGE 4: is_ram_addr properly gated onto wr_en_i
//     The data_ram wr_en_i already uses "mem_write_en && is_ram_addr" in
//     the original — kept as-is. ✓
//
//   CHANGE 5: cpu_clk exposed as output wire for testbench probing
//     Testbench needs cpu_clk to clock hierarchical probe signals at the
//     correct rate. Exposed as an internal wire (not a port) — testbench
//     accesses it via hierarchical reference: u_system.cpu_clk.
// =============================================================================

module system_top (
    input  wire       clk_in,
    input  wire       rst_n,
    output wire [7:0] leds
);

    // ─────────────────────────────────────────────────────────────
    // Internal Wires
    // ─────────────────────────────────────────────────────────────
    wire [31:0] instr;
    wire [31:0] pc;
    wire [31:0] mem_read_data_ram;
    wire [31:0] mem_read_data_rom;
    wire [31:0] final_read_data;
    wire [31:0] mem_write_data;
    wire [31:0] alu_result_out;
    wire [31:0] mem_write_data_aligned;
    wire        mem_write_en;
    wire        cpu_clk;                    // exposed for testbench hierarchical probe
    wire        pll_lock;
    wire [2:0]  funct3_out;
    wire        core_finish;
    wire        test_finished;
    wire        is_tohost_write;

    // ─────────────────────────────────────────────────────────────
    // 1. Address Decode — CORRECTED (CHANGE 3)
    // ─────────────────────────────────────────────────────────────
    // Memory map:
    //   ROM:  0x80000000 – 0x8000FFFF  (64 KB, instruction + rodata)
    //   RAM:  0x80010000 – 0x8001FFFF  (64 KB, data + stack)
    //   GPIO: 0x90000000 – 0x900000FF  (256 B, LED output)
    //
    // Using [31:16] decode isolates each 64 KB region exactly.
    // Original [31:22] was too coarse and produced overlapping ranges.
    // ─────────────────────────────────────────────────────────────
    wire is_ram_addr  = (alu_result_out[31:16] == 16'h8001);  // 0x80010000–0x8001FFFF
    wire is_rom_addr  = (alu_result_out[31:16] == 16'h8000);  // 0x80000000–0x8000FFFF
    wire is_gpio_addr = (alu_result_out[31:8]  == 24'h900000);// 0x90000000–0x900000FF

    // ─────────────────────────────────────────────────────────────
    // 2. Read Data Bus Mux
    // ─────────────────────────────────────────────────────────────
    assign final_read_data = is_ram_addr  ? mem_read_data_ram  :
                             is_rom_addr  ? mem_read_data_rom  :
                             32'b0;

    // ─────────────────────────────────────────────────────────────
    // 3. Test Finished Detection — single assignment (CHANGE 2)
    // ─────────────────────────────────────────────────────────────
    // RISCOF tohost write: address 0x803FFF00, non-zero data.
    // Firmware constructs this address as: lui 0x80400; addi -256.
    assign is_tohost_write = (alu_result_out == 32'h803FFF00)
                           && mem_write_en
                           && (mem_write_data != 32'b0);

    assign test_finished   = core_finish || is_tohost_write;   // ← ONE assignment only

    // ─────────────────────────────────────────────────────────────
    // 4. PLL — Clock Generation
    // ─────────────────────────────────────────────────────────────
    pll_clock u_pll (
        .clki_i  (clk_in),
        .rstn_i  (rst_n),
        .clkop_o (cpu_clk),
        .lock_o  (pll_lock)
    );

    // ─────────────────────────────────────────────────────────────
    // 5. RISC-V Core
    // ─────────────────────────────────────────────────────────────
    riscv_top u_core (
        .clk            (cpu_clk),
        .rst_n          (rst_n && pll_lock),
        .instr          (instr),
        .pc_out         (pc),
        .mem_read_data  (final_read_data),
        .mem_write_data (mem_write_data),
        .alu_result_out (alu_result_out),
        .mem_write_en   (mem_write_en),
        .funct3_out     (funct3_out),
        .test_finished  (core_finish)
    );

    // ─────────────────────────────────────────────────────────────
    // 6. Instruction ROM (dual-port, fully combinational read)
    // ─────────────────────────────────────────────────────────────
    // Port A: instruction fetch — pc[16:2] = word address within 64 KB ROM.
    // Port B: rodata constants  — alu_result_out[16:2].
    // Both reads are asynchronous (assign in instr_rom.v) — no clock needed.
    instr_rom u_rom (
        .addr_a_i    (pc[16:2]),
        .rd_data_a_o (instr),
        .addr_b_i    (alu_result_out[16:2]),
        .rd_data_b_o (mem_read_data_rom)
    );

    // ─────────────────────────────────────────────────────────────
    // 7. Store Data Alignment for SB / SH / SW
    // ─────────────────────────────────────────────────────────────
    // Byte/half-word stores replicate the data to fill the aligned word.
    // The byte-enable signal (ram_byte_we) selects which lanes commit.
    reg [3:0] ram_byte_we;

    always @(*) begin
        if (mem_write_en) begin
            case (funct3_out)
                3'b000: begin                           // SB — store byte
                    case (alu_result_out[1:0])
                        2'b00: ram_byte_we = 4'b0001;
                        2'b01: ram_byte_we = 4'b0010;
                        2'b10: ram_byte_we = 4'b0100;
                        2'b11: ram_byte_we = 4'b1000;
                        default: ram_byte_we = 4'b0000;
                    endcase
                end
                3'b001: begin                           // SH — store halfword
                    ram_byte_we = alu_result_out[1] ? 4'b1100 : 4'b0011;
                end
                3'b010: ram_byte_we = 4'b1111;         // SW — store word
                default: ram_byte_we = 4'b0000;
            endcase
        end else begin
            ram_byte_we = 4'b0000;
        end
    end

    assign mem_write_data_aligned =
        (funct3_out == 3'b000) ? {4{mem_write_data[7:0]}}  :   // SB: replicate byte
        (funct3_out == 3'b001) ? {2{mem_write_data[15:0]}} :   // SH: replicate halfword
         mem_write_data;                                        // SW: pass through

    // ─────────────────────────────────────────────────────────────
    // 8. Data RAM — custom data_ram.v (CHANGE 1: clk_i = cpu_clk)
    // ─────────────────────────────────────────────────────────────
    // CRITICAL CHANGE: clk_i is now cpu_clk (not ~cpu_clk).
    //
    // The custom data_ram.v internally uses:
    //   always @(posedge clk_i)  — write port
    //   always @(negedge clk_i)  — read port
    //
    // This eliminates the external clock inverter cell that caused the
    // 79.2% routing delay in the EX/MEM → RAM_WE critical path.
    // Lattice Radiant maps the two always blocks directly to the
    // EBR dual-edge primitive without inserting an inverter.
    //
    // All other port connections are IDENTICAL to the original.
    // ─────────────────────────────────────────────────────────────
    data_ram u_ram (
        .addr_i   (alu_result_out[16:2]),
        .ben_i    (ram_byte_we),
        .clk_en_i (1'b1),
        .clk_i    (cpu_clk),                   // ← CHANGED: was (~cpu_clk)
        .rst_i    (!rst_n),
        .wr_data_i(mem_write_data_aligned),
        .wr_en_i  (mem_write_en && is_ram_addr),
        .rd_data_o(mem_read_data_ram)
    );

    // ─────────────────────────────────────────────────────────────
    // 9. GPIO — LED Output Register
    // ─────────────────────────────────────────────────────────────
    // Writes to 0x90000000–0x900000FF update leds_reg[7:0].
    // The register is posedge-clocked — clean, synthesisable flip-flop.
    // leds is the combinational output of leds_reg (wire assignment).
    reg [7:0] leds_reg;

    always @(posedge cpu_clk or negedge rst_n) begin
        if (!rst_n)
            leds_reg <= 8'b0;
        else if (mem_write_en && is_gpio_addr)
            leds_reg <= mem_write_data[7:0];
    end

    assign leds = leds_reg;

endmodule
